BTLtech1/ripeomatic/data/contrib/README.md

# Contributed readings go in a folder named after the device id, e.g. contrib/a3f9c2/2026-11-09.csv
