BTLtech1/ripeomatic/hardware/stl/esp32-case/BTL-ESP32-case-Elegoo-DevKit-v6.3mf

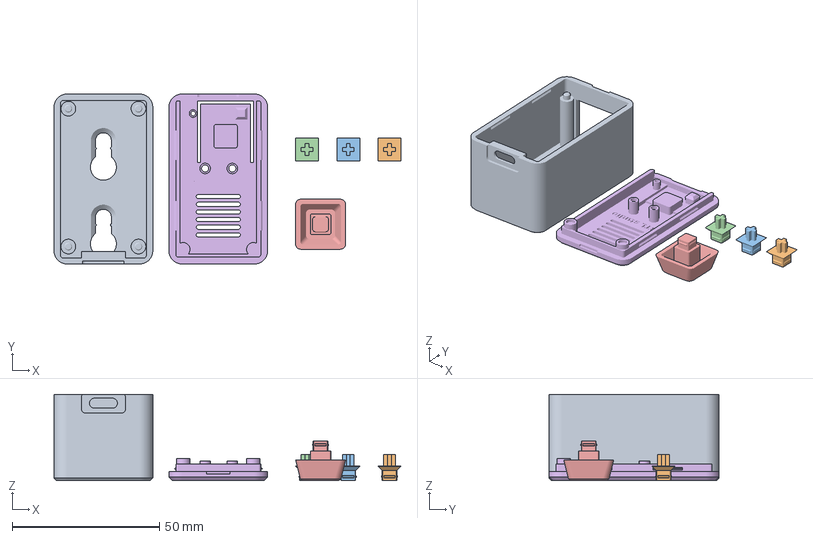
[picture p1: CAD file, 2026-11-07]
hardware/stl/esp32-case/BTL-ESP32-case-Elegoo-DevKit-v6.3mf
117.8 x 57.7 x 29.2 mm
base
MX adapter 1.35
MX adapter 1.30
MX adapter 1.25
keycap
lid (firm key)
