BTLtech1/ripeomatic/hardware/stl/gate-frame.stl

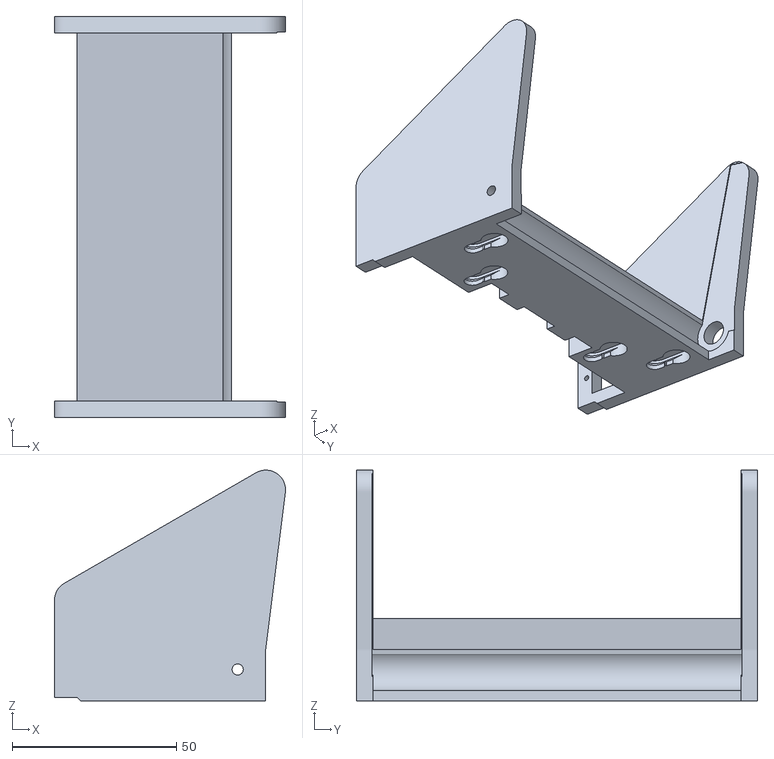
[picture p2: CAD file, 2026-11-14]
hardware/stl/gate-frame.stl
70.3 x 122.0 x 70.2
