BTLtech1/ripeomatic/hardware/stl/v45/v45-sled.stl

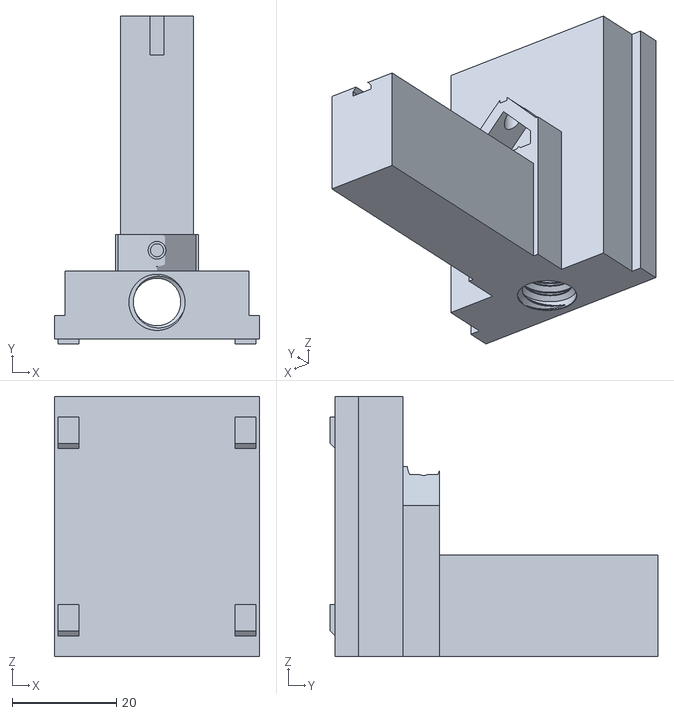
[picture p3: CAD file, 2026-11-12]
hardware/stl/v45/v45-sled.stl
39.4 x 63.0 x 50.0
