BTLtech1/ripeomatic/hardware/stl/esp32-case/esp32-case-mx-adapter-1.35.stl

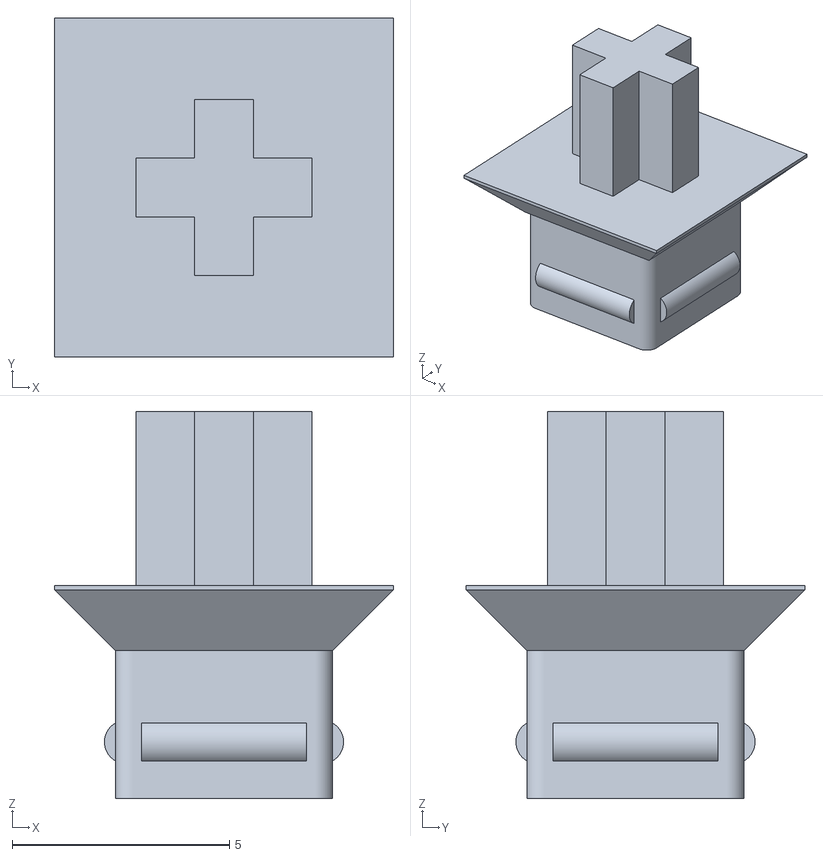
[picture p4: CAD file, 2026-11-07]
hardware/stl/esp32-case/esp32-case-mx-adapter-1.35.stl
7.80 x 7.80 x 8.90
