BTLtech1/ripeomatic/hardware/stl/ripeomatic-all-parts.3mf

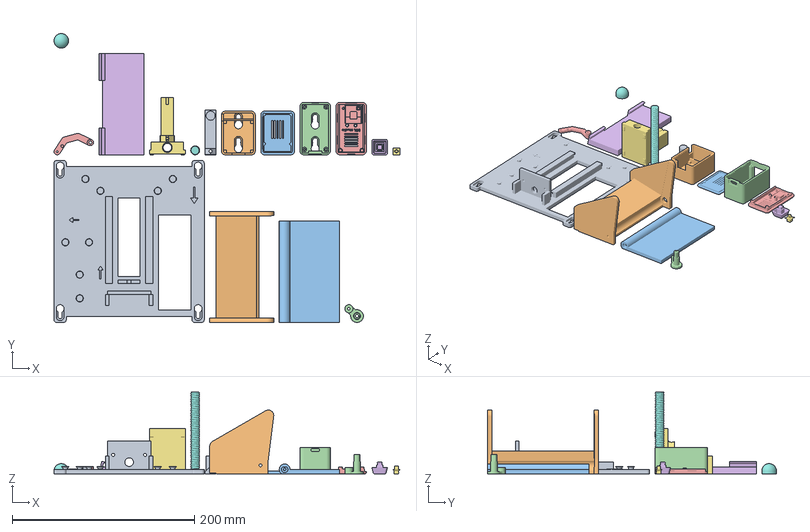
[picture p5: CAD file, 2026-11-14]
hardware/stl/ripeomatic-all-parts.3mf
379.9 x 317.2 x 90.0 mm
base
gate-frame
gate-door
gate-lever
gate-link
gate-liner-small
v45-sled
v45-lead-screw
v45-blade
driver-box
driver-box-lid
esp32-case-base
esp32-case-lid-firm-key
esp32-case-keycap
esp32-case-mx-adapter-1.30
pad-TPU
