BTLtech1/ripeomatic/hardware/stl/v45/v45-blade.stl

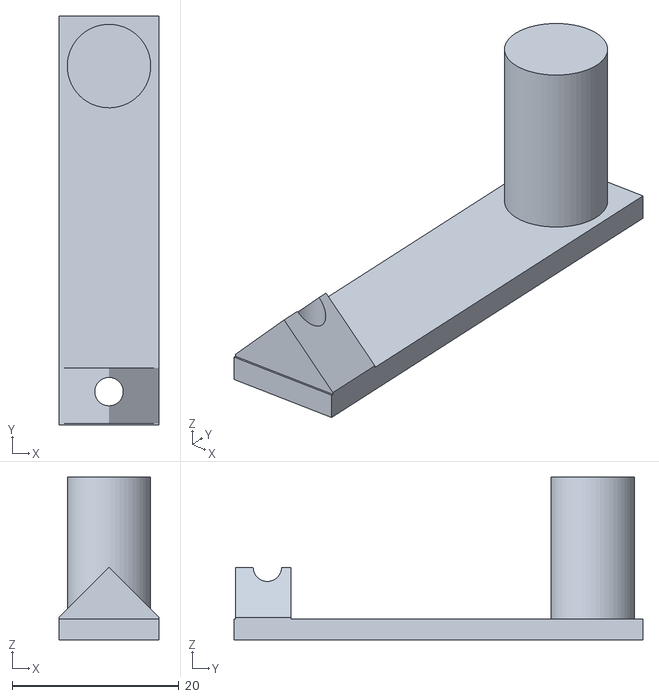
[picture p6: CAD file, 2026-11-09]
hardware/stl/v45/v45-blade.stl
12.0 x 49.0 x 19.5
