BTLtech1/ripeomatic/hardware/stl/base.stl

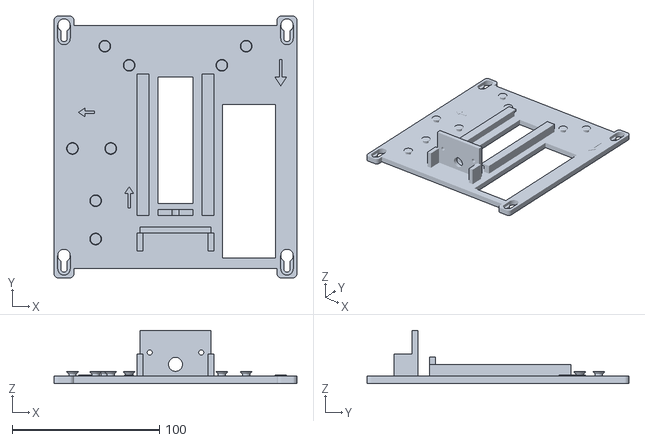
[picture p7: CAD file, 2026-11-14]
hardware/stl/base.stl
165.0 x 178.0 x 36.0
