BTLtech1/ripeomatic/hardware/stl/esp32-case/esp32-case-keycap.stl

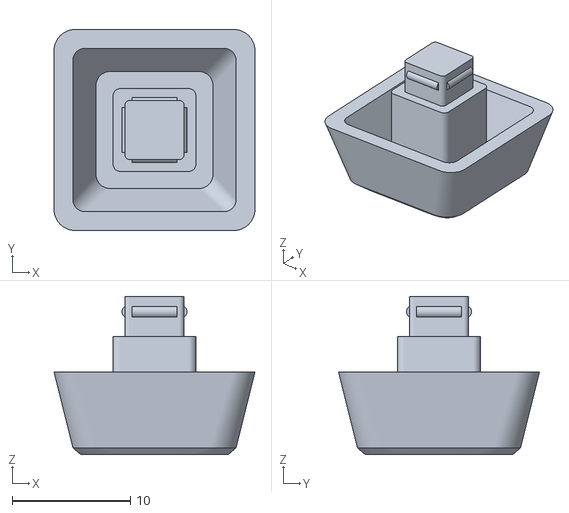
[picture p8: CAD file, 2026-11-07]
hardware/stl/esp32-case/esp32-case-keycap.stl
17.0 x 17.0 x 13.4
