BTLtech1/ripeomatic/hardware/stl/gate-liner-small.stl

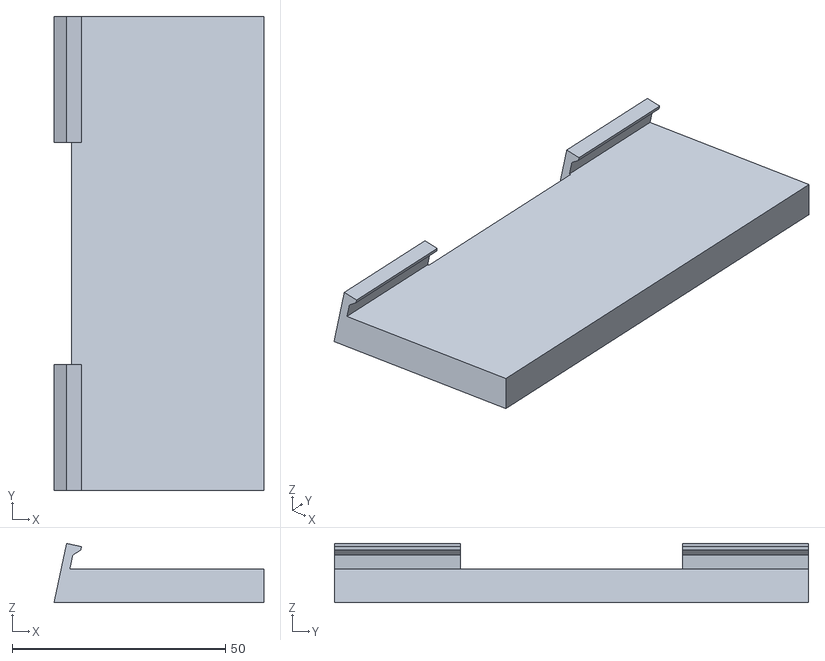
[picture p9: CAD file, 2026-11-12]
hardware/stl/gate-liner-small.stl
49.3 x 111.2 x 13.9
