BTLtech1/ripeomatic/hardware/stl/v45/v45-test-nuts.stl

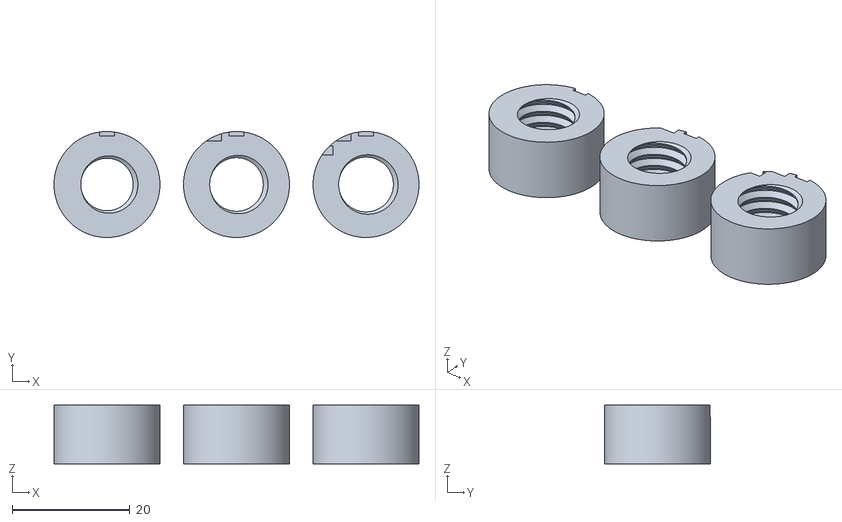
[picture p10: CAD file, 2026-11-08]
hardware/stl/v45/v45-test-nuts.stl
62.0 x 18.0 x 10.0
