BTLtech1/ripeomatic/hardware/stl/gate-door.stl

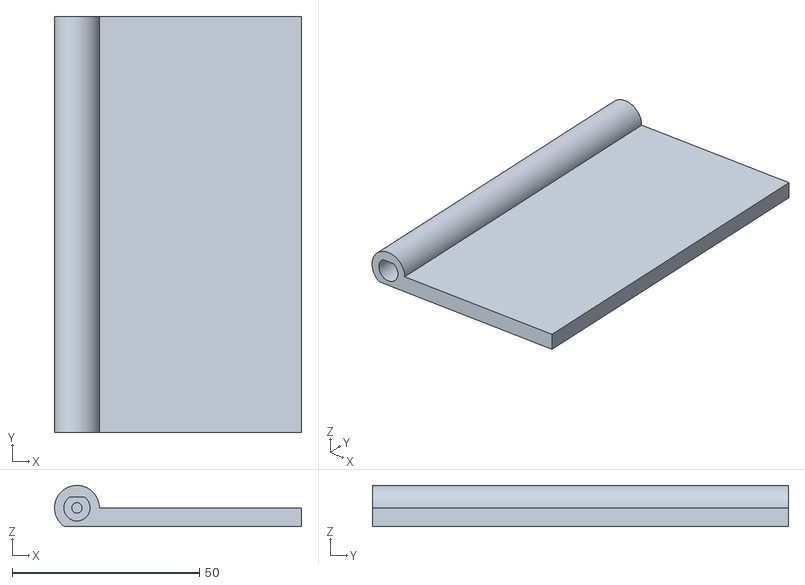
[picture p11: CAD file, 2026-11-12]
hardware/stl/gate-door.stl
66.0 x 111.2 x 11.0
