BTLtech1/ripeomatic/hardware/stl/esp32-case/esp32-case-lid-firm-key.stl

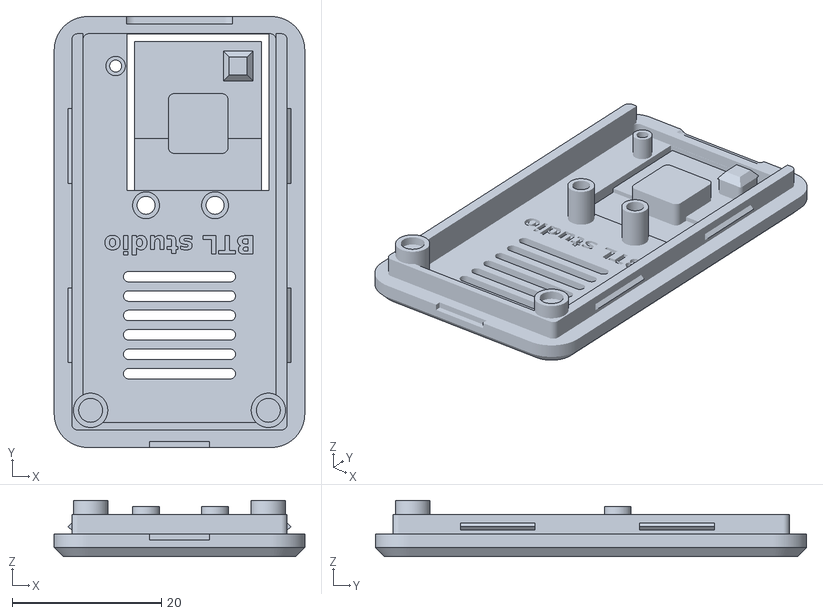
[picture p12: CAD file, 2026-11-07]
hardware/stl/esp32-case/esp32-case-lid-firm-key.stl
33.5 x 57.7 x 7.50
