BTLtech1/ripeomatic/hardware/stl/gate-link.stl

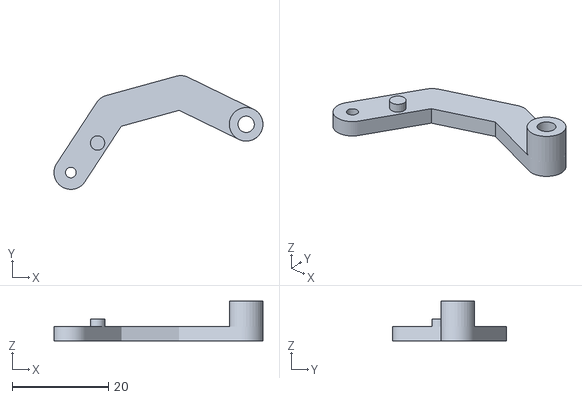
[picture p13: CAD file, 2026-11-12]
hardware/stl/gate-link.stl
43.5 x 23.7 x 8.30
