BTLtech1/ripeomatic/hardware/stl/esp32-case/esp32-case-base.stl

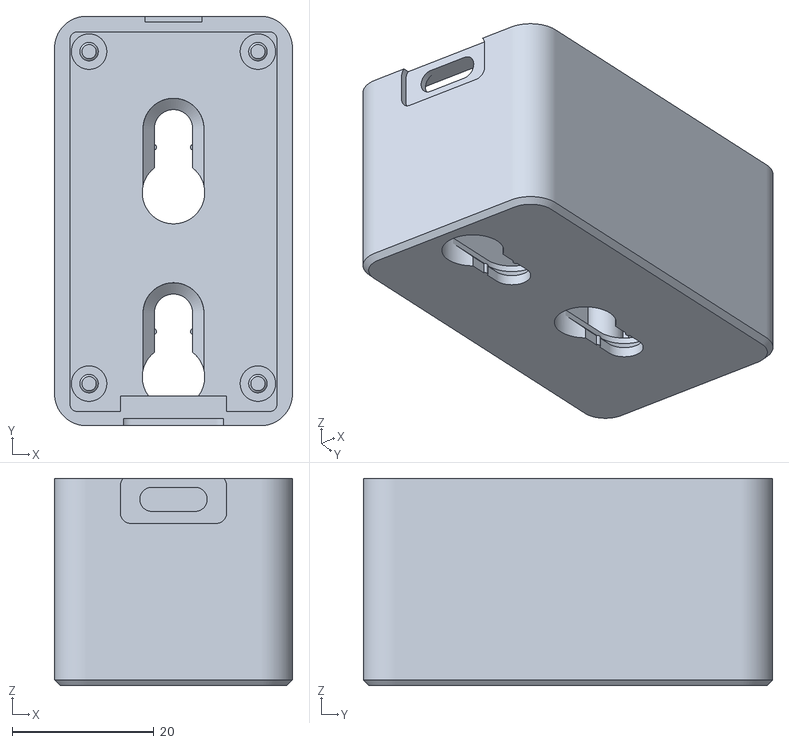
[picture p14: CAD file, 2026-11-07]
hardware/stl/esp32-case/esp32-case-base.stl
33.5 x 57.7 x 29.2
