BTLtech1/ripeomatic/hardware/stl/gate-lever.stl

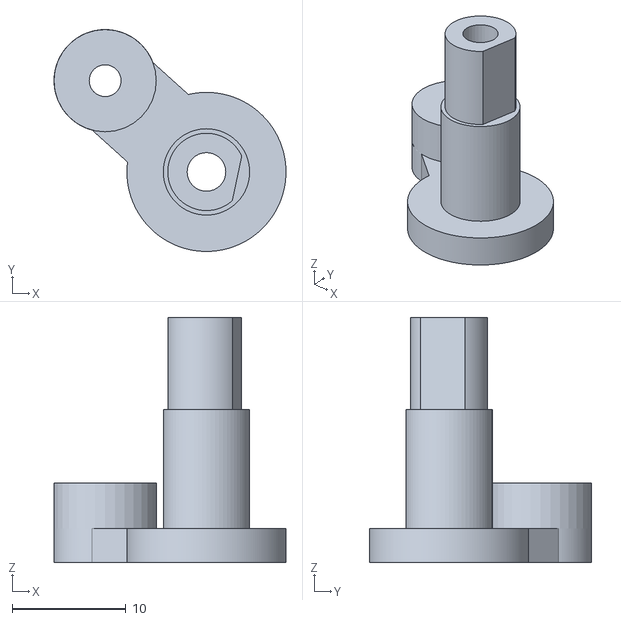
[picture p15: CAD file, 2026-11-12]
hardware/stl/gate-lever.stl
20.4 x 19.5 x 21.6
