BTLtech1/ripeomatic/hardware/stl/v-holder.stl

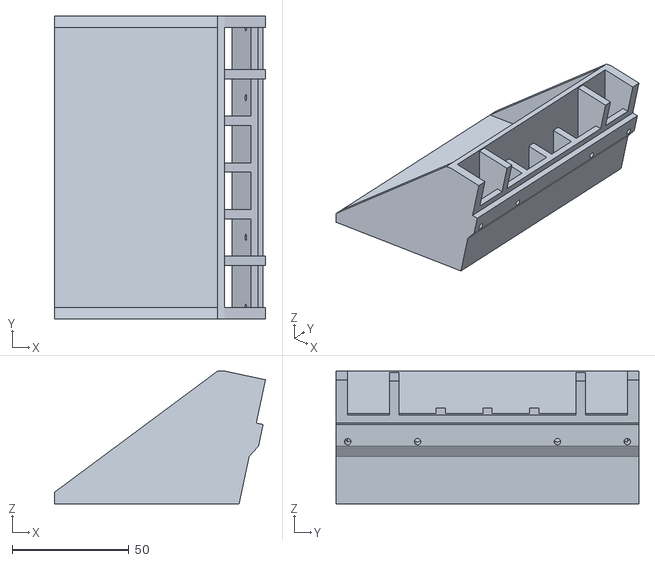
[picture p16: CAD file, 2026-11-12]
hardware/stl/v-holder.stl
90.5 x 130.0 x 57.0
