BTLtech1/ripeomatic/hardware/stl/base-v1-yoke-slot.stl

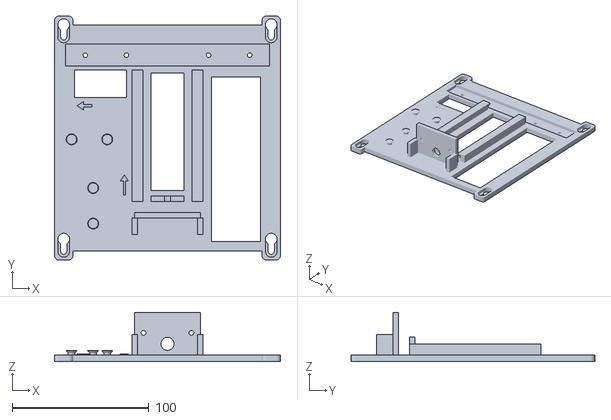
[picture p17: CAD file, 2026-11-12]
hardware/stl/base-v1-yoke-slot.stl
165.0 x 178.0 x 36.0
