BTLtech1/ripeomatic/hardware/stl/u-yoke.stl

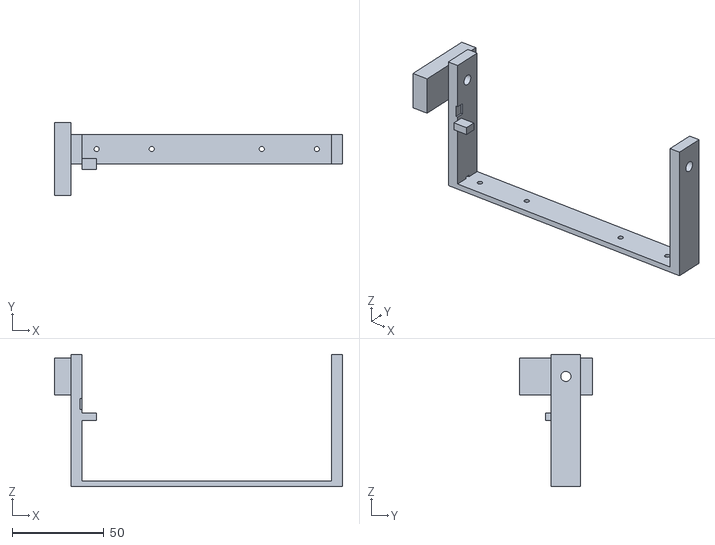
[picture p18: CAD file, 2026-11-12]
hardware/stl/u-yoke.stl
157.0 x 40.0 x 72.0
