BTLtech1/ripeomatic/hardware/stl/driver-box-lid.stl

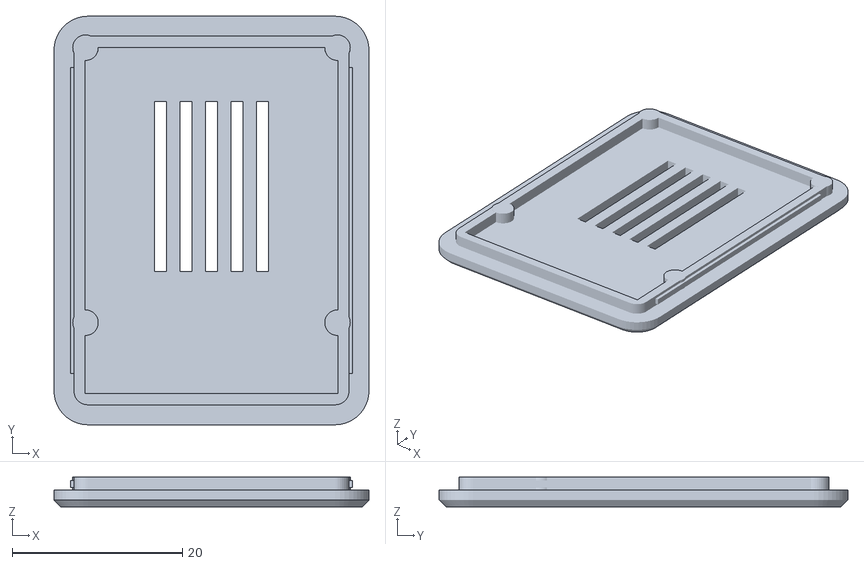
[picture p19: CAD file, 2026-11-09]
hardware/stl/driver-box-lid.stl
37.0 x 48.0 x 3.51
