BTLtech1/ripeomatic/hardware/stl/driver-box.stl

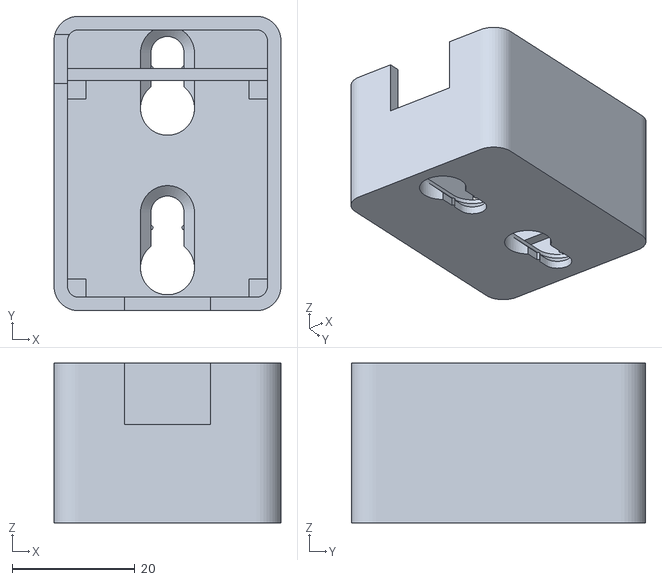
[picture p20: CAD file, 2026-11-07]
hardware/stl/driver-box.stl
37.0 x 48.0 x 26.0
