BTLtech1/ripeomatic/hardware/stl/nest.stl

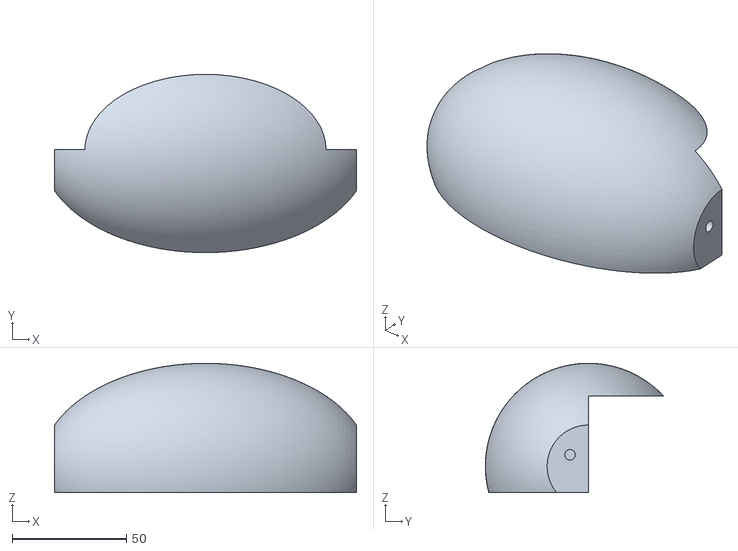
[picture p21: CAD file, 2026-11-06]
hardware/stl/nest.stl
132.0 x 77.9 x 56.6
