BTLtech1/ripeomatic/hardware/stl/servo-horn-v2.stl

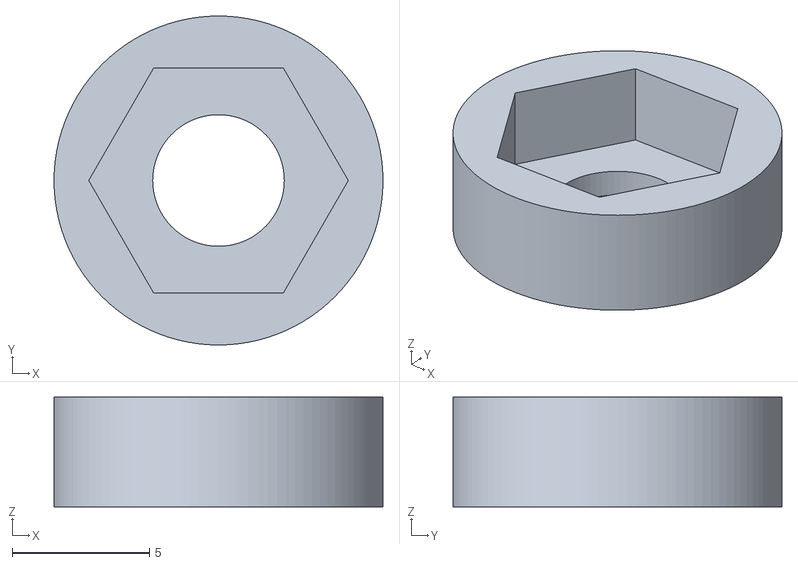
[picture p22: CAD file, 2026-11-06]
hardware/stl/servo-horn-v2.stl
12.0 x 12.0 x 4.00
