BTLtech1/ripeomatic/hardware/stl/blade.stl

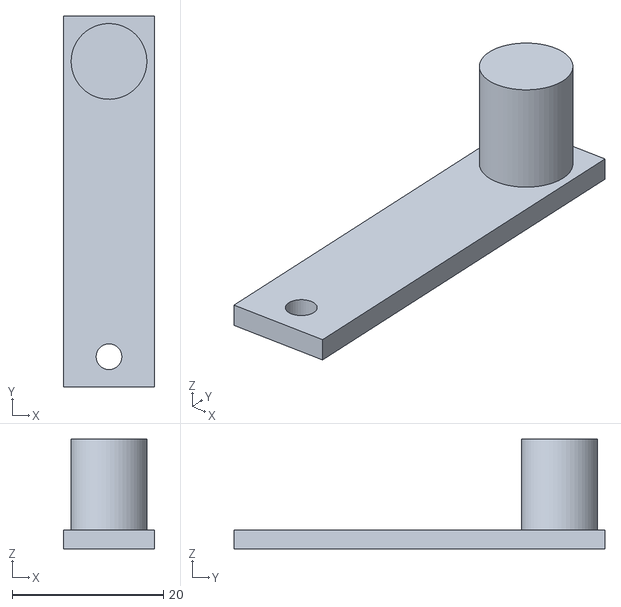
[picture p23: CAD file, 2026-11-06]
hardware/stl/blade.stl
12.0 x 49.0 x 14.5
