BTLtech1/ripeomatic/hardware/stl/pad-TPU.stl

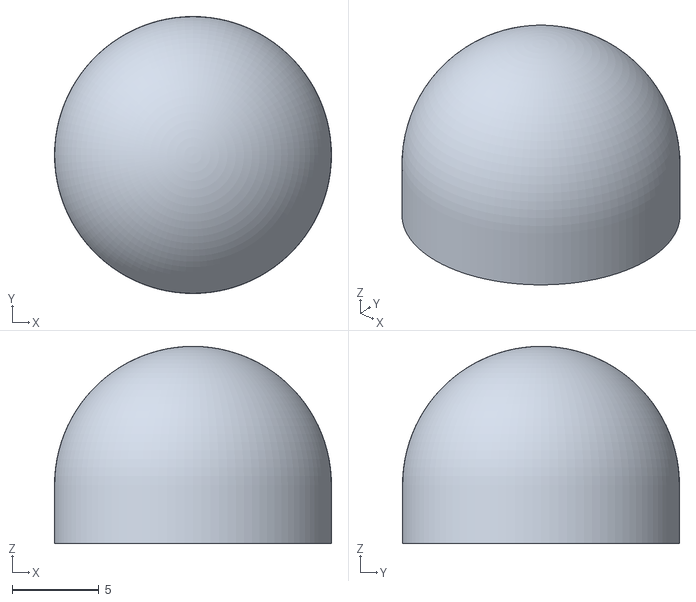
[picture p24: CAD file, 2026-11-06]
hardware/stl/pad-TPU.stl
16.0 x 16.0 x 11.4
