BTLtech1/ripeomatic/hardware/stl/nest-liner-TPU.stl

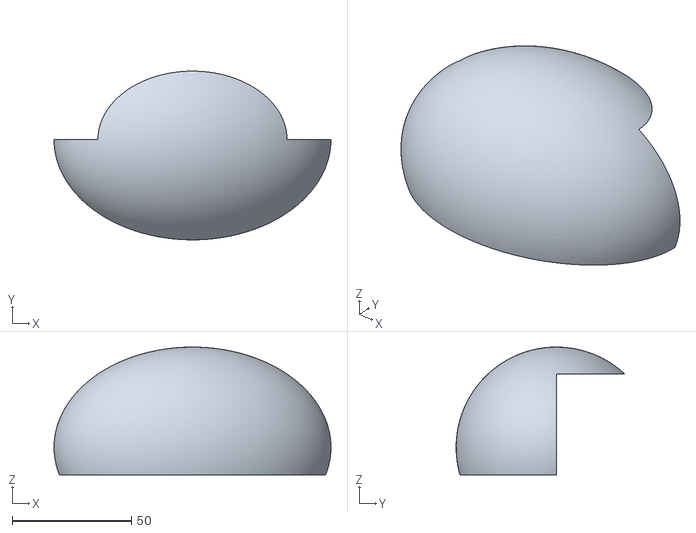
[picture p25: CAD file, 2026-11-06]
hardware/stl/nest-liner-TPU.stl
116.0 x 70.7 x 53.6
