BTLtech1/ripeomatic/(list of files, cad)

Other CAD files:
hardware/stl/esp32-case/esp32-case-mx-adapter-1.30.stl
hardware/stl/esp32-case/esp32-case-mx-adapter-1.25.stl
hardware/stl/sled.stl
hardware/stl/lead-screw-TR10x2.stl
hardware/stl/thumbscrew-knob.stl
hardware/stl/v45/v45-lead-screw.stl
hardware/stl/v45/v45-test-screw-30mm.stl
