BTLtech1/ripeomatic/firmware/ripeomatic/machine.h

// BTL Ripe-O-Matic: the machine. Owns the motor, the sensor, the measurement
// core and the fruit bookkeeping, and runs jobs (measure, jog, home, blade
// calibration, tip, notify) in their own FreeRTOS task so the web server keeps
// answering while the sled creeps for two minutes.
#pragma once
#include <Arduino.h>
#include "config.h"
#include "settings.h"
#include "measure.h"
#include "stepper.h"
#include "hall.h"
#include "storage.h"
#include "net.h"
#include "servo.h"
#include "updater.h"

enum class Job : uint8_t { Idle, Measure, Jog, Home, BladeCal, Tip, Notify, UpdateCheck, Update };

inline const char* jobName(Job j) {
  switch (j) {
    case Job::Idle: return "idle";
    case Job::Measure: return "measure";
    case Job::Jog: return "jog";
    case Job::Home: return "home";
    case Job::BladeCal: return "bladecal";
    case Job::Tip: return "tip";
    case Job::Notify: return "notify";
    case Job::UpdateCheck: return "updcheck";
    case Job::Update: return "update";
  }
  return "?";
}

struct LastReading {
  ripe::Outcome outcome = ripe::Outcome::None;
  char time[24] = "";
  float k = 0, r2 = 0, squish = 0, contact = 0, force_max = 0;
  int n_points = 0;
};

class Machine {
 public:
  Stepper28BYJ stepper;
  Hall hall;
  Storage store;
  Net net;
  NestServo servo;
  Updater upd;
  ripe::MeasureCore core;

  // live state for the UI (written by the job task, read by the web task)
  volatile Job job = Job::Idle;
  volatile ripe::Stage stage = ripe::Stage::Idle;
  volatile float live_force = 0;
  volatile float live_raw = 0;
  LastReading last;
  char error[64] = "";
  uint32_t last_measure_millis = 0;
  uint32_t boot_millis = 0;
  bool measured_since_boot = false;

  // A notification queued by the loop task (button) to be sent from the job task.
  char pendingTitle[32] = "", pendingMsg[96] = "";

  void begin() {
    boot_millis = millis();
    stepper.begin();
    applySettings();
    posLoad();
    hall.begin(&stepper);
    hall.tare();   // pad is normally in the air at boot; every reading tares again anyway
    store.begin();
    servo.begin();
    servo.relax();
  }

  void applySettings() {
    // Flipping the motor direction mirrors what "+" means, so mirror the step
    // count too: the sled hasn't moved, only the meaning of the sign.
    if (configured_ && S.motor_invert != lastInvert_) { stepper.setSteps(-stepper.steps()); posSave(false); }
    configured_ = true; lastInvert_ = S.motor_invert;
    stepper.configure(S.steps_per_mm, S.motor_invert);
    stepper.setSpeedMmS(S.fast_mm_s);
  }

  bool busy() const { return job != Job::Idle; }

  // ---- home ------------------------------------------------------------------
  // homeKnown: the step count matches the sled. homeLost: it was known, but the
  // power went off while the sled was moving, so the count can't be trusted.
  bool homeKnown = false;
  bool homeLost = false;

  // "Set home here": the sled is against the end stop at the motor end.
  bool setHomeHere() {
    if (busy()) return false;
    stepper.setSteps(0);
    homeKnown = true;
    homeLost = false;
    posSave(false);
    return true;
  }

  // Saved after every job that moves the sled; "moving" is set before it starts.
  void posSave(bool moving) {
    Preferences p; p.begin("pos", false);
    p.putInt("steps", (int)stepper.steps());
    p.putBool("known", homeKnown);
    p.putBool("moving", moving);
    p.end();
  }

  void posLoad() {
#if SIMULATE
    homeKnown = true;   // no motor: the count is always right
    return;
#endif
    Preferences p; p.begin("pos", false);
    bool known = p.getBool("known", false), moving = p.getBool("moving", false);
    long steps = p.getInt("steps", 0);
    p.end();
    if (known && !moving) { stepper.setSteps(steps); homeKnown = true; }
    else { homeKnown = false; homeLost = known && moving; }
  }

  // How far a jog may actually go (see jog()). 0 = nowhere.
  // past = the user confirmed the sled isn't really at home (the count is wrong, e.g. the motor lost
  // power for a while): a big step toward the motor may then go past home too.
  bool jogPast = false;
  float jogClamp(float mm, bool past = false) const {
    if (!homeKnown) return mm;
    float p = stepper.posMm();
    if (!past && mm < -1.01f && p + mm < 0) mm = p > 0 ? -p : 0;
    if (mm > 0 && p + mm > S.t.max_travel_mm) mm = p < S.t.max_travel_mm ? S.t.max_travel_mm - p : 0;
    return mm;
  }
  const char* jogBlocked(float mm, bool past = false) const {
    if (fabsf(jogClamp(mm, past)) >= 0.01f) return nullptr;
    return mm < 0 ? "at home. To creep closer to the end stop, use ◀ 1" : "at the travel limit";
  }

  static bool moves(Job j) { return j == Job::Measure || j == Job::BladeCal || j == Job::Jog || j == Job::Home; }

  // Both calibrations done: the force scale is known and the blade is subtracted.
  bool calibrated() const { return S.cal_points[0] != 0 && S.t.blade_k_n_per_mm > 0.01f; }

  // ---- starting jobs -------------------------------------------------------
  bool start(Job j, float param = 0) {
    if (busy()) return false;
    job = j;
    jobParam_ = param;
    stepper.clearAbort();
    error[0] = 0;
    if (moves(j)) posSave(true);   // if the power goes now, the count can't be trusted on the next boot
    // 16 kB: the ntfy push at the end runs TLS on this stack.
    BaseType_t ok = xTaskCreatePinnedToCore(taskEntry, "job", 16384, this, 1, &task_, 1);
    if (ok != pdPASS) { job = Job::Idle; strlcpy(error, "could not start task", sizeof error); return false; }
    return true;
  }

  void abort() { if (busy()) stepper.requestAbort(); }

  // A fresh, unguessable ntfy topic: ripe-<device id>-<6 random chars>.
  void newNtfyTopic() {
    static const char* alphabet = "abcdefghjkmnpqrstuvwxyz23456789";
    char rnd[7];
    for (int i = 0; i < 6; i++) rnd[i] = alphabet[esp_random() % 31];
    rnd[6] = 0;
    snprintf(S.ntfy_topic, sizeof S.ntfy_topic, "ripe-%s-%s", S.device_id, rnd);
    S.ntfy_ok = false;
    settingsSave();
  }

  // Queue a push notification; sent from the job task when it is free.
  void queueNotify(const char* title, const char* msg) {
    strlcpy(pendingTitle, title, sizeof pendingTitle);
    strlcpy(pendingMsg, msg, sizeof pendingMsg);
  }

  // Called from loop(): the scheduler.
  void tick() {
    if (busy()) return;
    if (pendingTitle[0]) { start(Job::Notify); return; }
    if (!S.auto_enabled) return;
    // Never press unattended until the machine has been set up: direction
    // checked, blade and force calibrated. Until then readings are manual.
    if (!calibrated() || !homeKnown) return;
    // ...and not while someone is in the middle of calibrating (machine on its back, coins on the pad).
    if (last_cal_millis_ && millis() - last_cal_millis_ < 10UL * 60 * 1000) return;
    uint32_t now = millis();
    // first reading a minute after boot, then every interval
    uint32_t due = measured_since_boot ? last_measure_millis + (uint32_t)(intervalHours() * 3600000.0f) : boot_millis + 60000;
    if ((int32_t)(now - due) >= 0) start(Job::Measure);
  }

  // Readings come faster once the fruit is nearly ripe.
  float intervalHours() const {
    float h = S.interval_h;
    if (FR.loaded && FR.last_k > 0) {
      ripe::Verdict v = ripe::judge(FR.last_k, FR.first_k, S.t);
      if (v == ripe::Verdict::Nearly) h = h / 2;
    }
    return h < 0.25f ? 0.25f : h;
  }

  int32_t secondsToNextAuto() const {
    if (!S.auto_enabled || !calibrated() || !homeKnown) return -1;
    uint32_t due = measured_since_boot ? last_measure_millis + (uint32_t)(intervalHours() * 3600000.0f) : boot_millis + 60000;
    int32_t d = (int32_t)(due - millis()) / 1000;
    return d < 0 ? 0 : d;
  }

  float thresholdNow() const {
    float thr = S.t.ripe_abs_n_per_mm > 0 ? S.t.ripe_abs_n_per_mm : 0;
    if (S.t.ripe_pct_of_first > 0 && FR.first_k > 0) {
      float rel = FR.first_k * S.t.ripe_pct_of_first / 100.0f;
      if (rel > thr) thr = rel;
    }
    return thr;
  }

  float elapsedDays() const {
    if (!FR.loaded) return -1;
    uint32_t now = Net::epoch();
    if (FR.start_epoch && now) return (now - FR.start_epoch) / 86400.0f;
    return (millis() - FR.start_millis) / 86400000.0f;
  }

  // Human rating from the web page or the button. Logged as its own row.
  bool rate(const char* rating, const char* cut, const char* notes) {
    char ts[24], fid[16], row[400];
    Net::isoNow(ts, sizeof ts);
    fruitId(fid, sizeof fid);
    ripe::RowMeta m{S.device_id, ts, fid, S.variety, 0, NAN, "", rating, cut ? cut : "", notes ? notes : ""};
    ripe::formatEventRow(m, row, sizeof row);
    strlcpy(FR.last_rating, rating, sizeof FR.last_rating);
    fruitSave();
    return store.appendRow(row);
  }

  // "New avocado" from the page: forget the current one; the next reading allocates the id.
  void forgetFruit() {
    FR.loaded = false;
    FR.last_contact_mm = 0;
    FR.last_rating[0] = 0;
    fruitSave();
  }

  // ---- force calibration ---------------------------------------------------
  float captureZero() {
    float raw = hall.readRaw(HALL_SAMPLES_TARE);
    S.cal_zero_counts = raw;
    S.cal_points[0] = 0;
    zeroCaptured_ = true;
    last_cal_millis_ = millis();
    settingsSave();
    return raw;
  }

  // Add a (grams, counts) point and refit newtons-per-count through the zero.
  // Requires a zero captured since boot, so a stale zero can't skew the scale.
  bool captureMass(float grams, const char** why) {
    *why = "";
    if (grams <= 0) { *why = "mass must be > 0"; return false; }
    if (!zeroCaptured_) { *why = "capture the zero first (nothing on the pad)"; return false; }
    float raw = hall.readRaw(HALL_SAMPLES_TARE);
#if SIMULATE
    raw = S.cal_zero_counts + grams / 1000.0f * 9.80665f / 0.0035f;   // pretend the coins are on the pad
#endif
    if (fabsf(raw - S.cal_zero_counts) < 3) { *why = "sensor didn't change: is the mass on the pad? is the magnet near the sensor?"; return false; }
    char pt[24];
    snprintf(pt, sizeof pt, "%s%.1f:%.0f", S.cal_points[0] ? ";" : "", grams, raw);
    if (strlen(S.cal_points) + strlen(pt) >= sizeof S.cal_points) { *why = "too many points; clear and redo"; return false; }
    strcat(S.cal_points, pt);
    refitCalibration();
    last_cal_millis_ = millis();
    settingsSave();
    return true;
  }

  int calPointCount() const {
    if (!S.cal_points[0]) return 0;
    int n = 1;
    for (const char* p = S.cal_points; *p; p++) if (*p == ';') n++;
    return n;
  }

  void clearCalibration() { S.cal_points[0] = 0; settingsSave(); }

  // ---- the jobs (run inside the task) -------------------------------------
 private:
  static void taskEntry(void* arg) {
    Machine* m = (Machine*)arg;
    m->runJob();
    if (moves(m->job)) m->posSave(false);
    m->job = Job::Idle;
    m->stage = ripe::Stage::Idle;
    m->task_ = nullptr;
    vTaskDelete(nullptr);
  }

  void runJob() {
    switch (job) {
      case Job::Measure:
        runMeasurement(false);
        // ripe and "drop ripe avocados" on: the sled has backed off, open the gate
        if (tipAfter_) { tipAfter_ = false; servo.tip(S.servo_rest_deg, S.servo_tip_deg, S.servo_hold_ms); }
        break;
      case Job::BladeCal: runMeasurement(true); break;
      case Job::Jog:      jog(jobParam_); stepper.release(); break;
      case Job::Home:     home(); stepper.release(); break;
      case Job::Tip:      servo.tip(S.servo_rest_deg, S.servo_tip_deg, S.servo_hold_ms); break;
      case Job::Notify:   net.notify(pendingTitle, pendingMsg, 2, "white_check_mark"); pendingTitle[0] = 0; pendingMsg[0] = 0; break;
      case Job::UpdateCheck: upd.check(); break;
      case Job::Update:
        stepper.release();
        if (upd.run()) { delay(2500); ESP.restart(); }   // let the page see "done" first
        break;
      default: break;
    }
  }

  // A move with no sensor-based stop condition of its own (homing, retract,
  // jog) still watches the sensor: if the raw reading changes by more than
  // `limit_n` worth of force from where it started, something is being pushed
  // that shouldn't be (inverted motor, wrong sign, fruit in the way) and the
  // move aborts. Sign- and tare-independent, so it works before calibration.
  bool guardedMove(float mm, float limit_n) {
    float npc = fabsf(S.hall_n_per_count) > 1e-6f ? fabsf(S.hall_n_per_count) : 0.0035f;
    float raw0 = hall.readRaw(16);
    float dir = mm >= 0 ? 1.0f : -1.0f, left = fabsf(mm);
    while (left > 0.001f && !stepper.aborted()) {
      float chunk = left > 0.5f ? 0.5f : left;
      stepper.moveMm(dir * chunk);
      left -= chunk;
      float raw = hall.readRaw(16);
      live_raw = raw;
      if (fabsf(raw - raw0) * npc > limit_n) {
        strlcpy(error, "unexpected force during a plain move: check motor_invert / the sensor sign", sizeof error);
        stepper.requestAbort();
        return false;
      }
    }
    return !stepper.aborted();
  }

  // Home is a step count, not a switch. The user sets it once with the sled
  // against the end stop ("Set home here"), the count is saved after every move,
  // and nothing ever drives into the stop on purpose: running into it made the
  // 28BYJ-48 pull the lead screw off its shaft instead of slipping.
  void home() {
    stage = ripe::Stage::Homing;
    if (!homeKnown) { strlcpy(error, HOME_UNSET_MSG, sizeof error); stepper.requestAbort(); return; }
    stepper.setSpeedMmS(S.fast_mm_s);
    float p = stepper.posMm();
    if (fabsf(p) > 0.001f) guardedMove(-p, 1.5f);
  }

  // Jog from the Motor panel. With home set, big steps stop at home and at the
  // travel limit; a 1 mm step toward the motor may go past home, so a wrong home
  // can be corrected by creeping up to the real end stop.
  void jog(float mm) {
    mm = jogClamp(mm, jogPast);
    jogPast = false;
    if (fabsf(mm) < 0.01f) return;
    guardedMove(mm, S.t.force_cap_n);
  }

  void runMeasurement(bool bladeCal) {
    ripe::Tunables t = S.t;
    if (bladeCal) t.blade_k_n_per_mm = 0;   // we want the raw machine slope
    // Until the force scale is calibrated the cap is a guess: keep the
    // position backstop short so a wrong guess can't turn into a deep press.
    if (!S.cal_points[0] && t.max_squish_mm > 3.0f) t.max_squish_mm = 3.0f;

    if (!homeKnown) { finishAborted(HOME_UNSET_MSG); return; }
    home();
    if (stepper.aborted()) { finishAborted(error[0] ? error : "stopped"); return; }

    stage = ripe::Stage::Taring;
    delay(300);                     // let the blade stop wobbling
    hall.tare();
    live_raw = hall.tareCounts();
    live_force = 0;
    if (live_raw < 20 || live_raw > 4075) { finishAborted("hall sensor saturated: magnet too close/far, or wiring"); retract(); return; }

    core.start(t, bladeCal ? 0 : FR.last_contact_mm);
    stage = core.stage();
    float pos = stepper.posMm();
    float force = hall.readForce();
    int negativeRun = 0;
    while (true) {
      ripe::MeasureCore::Cmd c = core.feed(pos, force);
      stage = core.stage();
      if (c.kind == ripe::MeasureCore::Cmd::Stop) break;
      stepper.setSpeedMmS(c.fast ? S.fast_mm_s : S.creep_mm_s);
      stepper.moveMm(c.mm);
      if (stepper.aborted()) { core.abort(); break; }
      pos = stepper.posMm();
      float raw = hall.readRaw(HALL_SAMPLES_LIVE);
      force = hall.countsToForce(raw);
      live_raw = raw;
      live_force = force;
      // Sensor sanity. The force should never go strongly negative while we
      // push: if it does, hall_n_per_count has the wrong sign (or the magnet
      // is flipped). One sample well below zero is enough during the fast
      // approach, where each step is 0.5 mm.
      bool bad = force < -0.5f * t.force_cap_n;
      if (force < -3 * t.contact_threshold_n) bad = bad || ++negativeRun >= 2; else negativeRun = 0;
      if (bad) { core.abort(); strlcpy(error, "force reads negative: flip the sign of hall_n_per_count (or the magnet)", sizeof error); break; }
      if (raw < 20 || raw > 4075) { core.abort(); strlcpy(error, "hall sensor saturated: magnet too close/far, or wiring", sizeof error); break; }
    }

    retract();

    const ripe::Reading& r = core.reading();
    char ts[24];
    Net::isoNow(ts, sizeof ts);
    last.outcome = r.outcome;
    if (ts[0]) strlcpy(last.time, ts, sizeof last.time);
    else snprintf(last.time, sizeof last.time, "up+%lu", (unsigned long)(millis() / 1000));   // clock not set yet
    last.k = r.stiffness_n_per_mm; last.r2 = r.r2; last.squish = r.squish_at_cap_mm;
    last.contact = r.contact_pos_mm; last.force_max = r.force_max_n; last.n_points = r.n_points;
    last_measure_millis = millis();
    measured_since_boot = true;

    if (bladeCal) {
      if (r.outcome == ripe::Outcome::Reading && r.stiffness_n_per_mm > 0.2f) {
        S.t.blade_k_n_per_mm = r.stiffness_n_per_mm;
        last_cal_millis_ = millis();
        settingsSave();
        Serial.printf("blade_k = %.2f N/mm (r2 %.3f)\n", r.stiffness_n_per_mm, r.r2);
      } else if (!error[0]) {
        strlcpy(error, "blade calibration failed: nothing hard where the avocado goes?", sizeof error);
      }
      return;
    }

    switch (r.outcome) {
      case ripe::Outcome::Reading:
      case ripe::Outcome::Overtravel:
        processReading(r, ts);
        break;
      case ripe::Outcome::Empty:
        if (FR.loaded) {
          FR.loaded = false;
          fruitSave();
          net.notify("No avocado", "The avocado is gone. Put the next one in.", 2, "avocado");
        }
        break;
      case ripe::Outcome::Aborted:
        if (!error[0]) strlcpy(error, "stopped", sizeof error);
        break;
      default: break;
    }
  }

  // Always come back and let go of the fruit, even after an abort.
  void retract() {
    stage = ripe::Stage::Retract;
    stepper.clearAbort();
    stepper.setSpeedMmS(S.fast_mm_s);
    guardedMove(-stepper.posMm(), S.t.force_cap_n + 1.0f);   // back to home by count; never into the stop
    stepper.release();
    stepper.clearAbort();
  }

  void finishAborted(const char* why) {
    strlcpy(error, why, sizeof error);
    last.outcome = ripe::Outcome::Aborted;
    stepper.clearAbort();
    stepper.release();
  }

  void processReading(const ripe::Reading& r, const char* ts) {
    // New avocado?
    bool isNew = !FR.loaded || ripe::looksLikeNewFruit(r.contact_pos_mm, FR.first_contact_mm, r.stiffness_n_per_mm, FR.last_k, S.t);
    if (isNew) {
      fruitNew();
      FR.loaded = true;
      FR.first_contact_mm = r.contact_pos_mm;
      FR.first_k = r.stiffness_n_per_mm;
      FR.start_epoch = Net::epoch();
      FR.start_millis = millis();
    }
    FR.last_k = r.stiffness_n_per_mm;
    FR.last_contact_mm = r.contact_pos_mm;
    FR.n_readings++;
    FR.last_rating[0] = 0;

    // Log it.
    char fid[16], row[700], notes[48] = "";
    fruitId(fid, sizeof fid);
    if (r.outcome == ripe::Outcome::Overtravel) strlcpy(notes, "overtravel: cap not reached", sizeof notes);
    else if (isNew && FR.counter > 1) strlcpy(notes, "new fruit detected", sizeof notes);
    ripe::RowMeta m{S.device_id, ts, fid, S.variety, 0, NAN, S.cal_points, "", "", notes};
    ripe::formatReadingRow(r, m, S.t.force_cap_n, row, sizeof row);
    store.appendRow(row);
    Serial.println(row);

    // Verdict + notifications (once per fruit each).
    ripe::Verdict v = ripe::judge(FR.last_k, FR.first_k, S.t);
    char msg[160];
    if (v == ripe::Verdict::Ripe && !FR.notified_ripe) {
      snprintf(msg, sizeof msg, "Stiffness %.2f N/mm (%.0f%% of day 1). Eat it today or fridge it.", FR.last_k, FR.first_k > 0 ? 100 * FR.last_k / FR.first_k : 0);
      bool drop = S.gate_auto && S.gate_fitted && ENABLE_SERVO;
      if (drop) { strlcat(msg, " It's in the basket.", sizeof msg); tipAfter_ = true; }
      if (net.notify("Avocado is ripe", msg, 4, "avocado,tada")) FR.notified_ripe = true;
    } else if (v == ripe::Verdict::Nearly && S.notify_nearly && !FR.notified_nearly) {
      float d = ripe::daysToRipe(FR.first_k, FR.last_k, elapsedDays(), thresholdNow());
      snprintf(msg, sizeof msg, "Stiffness %.2f N/mm. Probably ripe %s.", FR.last_k, d > 0 && d < 1.5f ? "tomorrow" : "in a day or two");
      if (net.notify("Avocado almost ripe", msg, 3, "avocado")) FR.notified_nearly = true;
    }
    fruitSave();
  }

  void refitCalibration() {
    // points: grams:counts;...  fit force (N) vs (counts - zero), least squares including (0,0)
    float x[6], y[6];
    int n = 0;
    x[n] = 0; y[n] = 0; n++;
    const char* p = S.cal_points;
    while (*p && n < 6) {
      float g = atof(p);
      const char* c = strchr(p, ':');
      if (!c) break;
      float counts = atof(c + 1);
      x[n] = counts - S.cal_zero_counts;
      y[n] = g / 1000.0f * 9.80665f;
      n++;
      const char* s = strchr(p, ';');
      if (!s) break;
      p = s + 1;
    }
    if (n >= 2) {
      ripe::LineFit f = ripe::fitLine(x, y, n);
      if (fabsf(f.slope) > 1e-7f) {
        float old_npc = S.hall_n_per_count;
        S.hall_n_per_count = f.slope;
        // blade_k was measured in newtons of the OLD scale; it scales exactly with the sensor scale.
        if (S.t.blade_k_n_per_mm > 0 && fabsf(old_npc) > 1e-7f) S.t.blade_k_n_per_mm *= fabsf(f.slope / old_npc);
      }
    }
  }

  TaskHandle_t task_ = nullptr;
  float jobParam_ = 0;
  bool configured_ = false, lastInvert_ = false;
  bool tipAfter_ = false;       // set by processReading when a ripe fruit should go in the basket
  bool zeroCaptured_ = false;   // captureZero() done since boot
  uint32_t last_cal_millis_ = 0;
};

extern Machine M;
