BTLtech1/ripeomatic/(commit log)

2026-11-03 Initial project structure
    README, measurement routine, hardware BOM, firmware plan,
    data template, MIT (code) and CC BY-SA 4.0 (hardware) licenses.
    Claude-Session: https://claude.ai/code/session_01Nn3xvgmK6v36sKnHTDxFfD
    [readings_template.csv]
2026-11-03 Switch to the printable edition: $15-20 BOM, no bearings or load cell
    28BYJ-48 geared stepper on a printed lead screw, carriage sliding on
    printed posts, printed PLA flexure + SS49E hall sensor for force
    sensing, everything on 5 V USB. Updated BOM, wiring, firmware
    settings and the measurement routine (flexure correction, coin
    calibration).
    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
2026-11-03 Move the motor to the base
    Motor sits shaft-up in a printed cup in the base plate, next to its
    driver. Lead screw gets a thrust flange under the top plate; top plate
    becomes a plain post cap. Only the hall sensor lead moves now.
    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
2026-11-03 Switch to the horizontal press layout
    Low caliper-style press: one flat base print with a guide channel,
    motor plate, end stop, V-trough and soft backstop. Sled slides in the
    channel; a vertical printed blade with magnet + hall sensor reads force.
    Push reaction seats the screw on the motor shaft, so no retaining
    flange. Docs, BOM, wiring and measurement routine updated.
    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
2026-11-03 Nest instead of trough and backstop; pad on a stem; hinge knuckle for v2
    Half-shell avocado nest with soft liner and front lip replaces the two
    rails and wall. Pad moves to a 12 mm stem so the sled clears the
    pedestal for small fruit; far screw bracket moved. GoPro-style hinge
    knuckle at the nest's rear edge, with v2 tipping servo noted.
    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
2026-11-03 Trunnion hinge through the fruit centre instead of a rear-edge knuckle
    Nest hangs between two yoke arms on M5 pins at pad height. The push
    passes through the axis so readings can't tip it, and the loaded nest
    is nearly balanced for the v2 tipping servo.
    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
2026-11-03 Compact layout: 40 mm travel, 90 mm screw, 185 x 150 base; nest sized for 80 mm fruit
    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
2026-11-03 Longer sled with runner pads, no far screw bracket; friction notes
    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
2026-11-03 U-yoke printed flat, rib ears on the nest, servo planned into v1 print
    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
2026-11-03 Scoop-cut nest for a 110 degree dump; servo boss and stop tab; base trimmed behind the yoke
    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
2026-11-03 Fusion 360 model and STLs for v1
    Base 165x165 with lightening windows, rails, motor plate, yoke recess,
    board mounts; sled with TR10x2 nut, post and blade riser; blade; pad;
    TR10x2 lead screw; scoop nest with hinge ears; TPU liner; U-yoke with
    stop tab and servo boss; knob; v2 servo horn. Print/assembly guide.
    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
    [base.stl, blade.stl, lead-screw-TR10x2.stl, nest-liner-TPU.stl, nest.stl, pad-TPU.stl, servo-horn-v2.stl, sled.stl]
2026-11-03 Rounded hinge lugs on the nest
    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
    [nest.stl]
2026-11-03 Flat-ended nest: bolts thread into 8 mm end walls, no lugs; yoke arms moved in to match
    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
    [nest-liner-TPU.stl, nest.stl, servo-horn-v2.stl, thumbscrew-knob.stl, u-yoke.stl]
2026-11-03 Data-sharing plan: record schema, collection path, pooled-data uses; capacitor in wiring notes
    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
2026-11-03 Slide-in cradle for the ULN2003 instead of standoffs; groove fix on both cradles
    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
    [base.stl]
2026-11-03 Board cover: drop-over lid for the ESP32 and ULN2003 cradles
    1.2 mm walls, vent slots, wire gap on the inner edge, USB notch and a
    hook tab at the nest end, one M3 boss at the other end screwed from
    below (new 3.4 mm hole in the base). Notched where it meets the ULN
    cradle rail ends. Docs: print list, hardware, assembly step, and a note
    that the ESP32 goes in USB toward the nest.
    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
    [base.stl, board-cover.stl]
2026-11-03 Firmware first pass: measurement state machine, web app, CSV log, ntfy push
    One ESP32 sketch, core libraries only. measure.h is pure C++ and unit-tested
    against a simulated avocado (recovers the fruit's stiffness through the blade
    correction, finds contact to 0.1 mm, handles empty nest / mush / close fruit).
    machine.h runs home-tare-approach-creep-press-retract in its own task, detects
    swaps, logs schema-v1 rows to LittleFS and pushes 'almost ripe' / 'ripe' /
    'nest empty' through ntfy. web.h serves the embedded page (PWA) and a JSON
    API; net.h does a setup AP with captive portal, mDNS, NTP. Coin + blade
    calibration wizard, motor jog, settings, Wi-Fi from the page; BOOT button
    measures / rate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
2026-11-03 Data pipeline: validator/merge script, GitHub Actions, synthetic sample
    tools/merge_data.py checks contrib/<device_id>/*.csv against schema v1 (header,
    ids, ISO timestamps, numeric columns, rating/cut vocabularies, curve format),
    dedups and writes data/all.csv. The data workflow validates PRs and rebuilds
    all.csv on main. The firmware workflow runs the unit tests, the sketch
    type-check, the ui.h freshness check and the headless-browser smoke test
    against the mock device. tools/make_sample.py writes a clearly synthetic
    data/sample/sample.csv (device 000000) for trying the dashboard.
    Claude-Session: https://claude.ai/code/session_01Nn3x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
    [readings_template.csv, sample.csv]
2026-11-03 data: rebuild all.csv
    [all.csv]
2026-11-03 Community dashboard on GitHub Pages
    dashboard/index.html reads data/all.csv (falls back to the synthetic sample
    with a banner, or opens a CSV from your computer): hero tile with the median
    stiffness at 'perfect', ripening curves with rating markers and nearest-point
    hover, stiffness-by-rating strip, days-to-perfect vs temperature, sortable
    table, variety/device filters, light and dark. pages.yml deploys it to
    https://btltech1.github.io/ripeomatic/ (enable Pages: Settings > Pages >
    Source: GitHub Actions, if the workflow can't turn it on itself).
    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
2026-11-03 Wiring diagram for the hardware README
    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
2026-11-03 Firmware: fixes from an independent review before first flash
    Blocker: Net::ntfy() let HTTPClient outlive the WiFiClient it was given
    (use-after-free in end(); would have reboot-looped on every notification).
    Safety: automatic readings stay off until both calibrations are done and for
    10 min after any calibration capture; homing, retract and jog are now guarded
    moves that abort if the sensor reading changes by more than the force cap
    (catches an inverted motor or wrong sensor sign before anything is pushed);
    hall saturation aborts a press; the squish backstop drops to 3 mm while the
    force scale is still a guess; wrong-sign detection trips on the first strongly
    negative sample during the fas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
    [config.h, machine.h, mock_device.py, net.h, ripeomatic.ino, settings.h, web.h]
2026-11-03 SIMULATE: fake the coin mass so the calibration flow works on a bare board
    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
2026-11-05 CI: compile the firmware with the real ESP32 toolchain, export single-image binaries
    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
2026-11-05 Improv Wi-Fi over serial; min_spiffs partition (app was at 95%); unpadded merged image
    improv.h answers the web installer's Improv Serial protocol: device info,
    state, network scan, and Wi-Fi settings (connects, saves, replies with the
    device URL, reboots into station mode). Framing/checksum is host-tested.
    The real-toolchain build showed the sketch at 95% of the default 1.25 MB app
    partition, so the build, PlatformIO and the README now use Minimal SPIFFS
    (1.9 MB app with OTA, 190 kB filesystem; log rotation at 80 kB). CI merges
    the image with esptool so it is ~1.3 MB rather than a padded 4 MB.
    Claude-Session: https://claude.ai/code/s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
    [config.h, improv.h, ripeomatic.ino]
2026-11-05 Device page: first-run setup checklist (alerts, motor direction, calibrations, first avocado)
    One step at a time, with the firmware doing the thinking: /api/ntfy/new makes a
    private topic and the page links the phone straight to it, /api/ntfy/test
    sends a push from the job task and ticks the step when it lands, and
    /api/motor/checked turns 'it went the wrong way' into a motor_invert flip.
    Calibration steps moved from the settings panel into the checklist. The mock
    and the browser smoke test walk all five steps.
    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
    [machine.h, mock_device.py, net.h, settings.h, web.h]
2026-11-05 Installer: 'which one is the board' help, Install button labels, 2.4 GHz tip (from the print bridge installer)
    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
2026-11-05 Docs: the hall sensor capacitor is optional
    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
2026-11-05 Installer: device names as non-wrapping chips
    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
2026-11-05 Installer: name the CP2102 entry exactly, explain the Paired tag, driver step inline
    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
2026-11-05 Installer: Windows driver as its own step for the ELEGOO/CP2102 board; tested-board notes
    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
2026-11-05 Device page: Wi-Fi panel says what it's for (connected to X; change only if the network changes)
    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
2026-11-05 Simulation: 20x motor speed so a pretend reading takes ~10 s; page says it's a simulation
    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
2026-11-06 STLs rotated into print orientation; tools/orient_stl.py; print guide corrected
    The Fusion exports were in model coordinates (Y up), so every part landed on
    its side in the slicer. orient_stl.py rotates each file per a per-part rule,
    rests it on Z=0 and centres it, and reports footprint and bed contact. That
    check showed the guide was wrong for two parts: the nest 'cup up' rests on a
    point (now upside down on its flat top edge, 1150 mm2 of contact, no
    supports) and the U-yoke can't lie flat because the servo boss is wider than
    the arm (now standing on its cross-bar with supports under the boss; a later
    CAD revision should widen the arm there).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
    [base.stl, blade.stl, board-cover.stl, lead-screw-TR10x2.stl, nest-liner-TPU.stl, nest.stl, pad-TPU.stl, servo-horn-v2.stl]
2026-11-07 Base: keyhole studs for a slide-on electronics box, cradles and cover retired
    The slide-in board cradles could not hold a DevKit (the pin headers sit at
    the board edge, so there is no edge for the grooves to grip). The shelf is
    now flat with two BTL universal-mount v3 studs 26 mm apart (stem Ø5 × 1.4,
    45° cone to Ø8, 3.3 mm tall), so any box with the matching keyholes slides
    on and clamps itself. Cradle features and the cover screw hole are
    suppressed in the Fusion timeline, not deleted; board-cover.stl is dropped.
    - hardware/keyhole-mount.md: stud and keyhole dimensions, shelf size,
    stud positions, how to get the cradle version back
    - print guide / hardware README / README: box inste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
    [base.stl, board-cover.stl]
2026-11-07 Two electronics boxes on keyhole studs: BTL ESP32 case v6 + new driver box
    The ESP32 goes in BTL's existing ESP32 case for the ELEGOO DevKit (v6, with
    the BOOT keycap), the ULN2003 in a new driver box drawn in the same style.
    Both click onto BTL universal-mount studs printed into the base, one pair
    each side of the channel at the motor end; part of the far-side window is
    filled in to carry the second pair. The keyhole spec now comes from the v6
    case itself (Ø8.8 round, 5.4 slot, 9 mm slide, 45° flare, detent nibs).
    - hardware/stl/base.stl: four studs, window fill
    - hardware/stl/driver-box.stl, driver-box-lid.stl: new (Fusion component
    DriverBox: keyhole floor, board ledges, wire notches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
    [BTL-ESP32-case-Elegoo-DevKit-v6.3mf, base.stl, driver-box-lid.stl, driver-box.stl, esp32-case-base.stl, esp32-case-keycap.stl, esp32-case-lid-firm-key.stl, esp32-case-mx-adapter-1.25.stl]
2026-11-07 Sled: prints standing on its motor end, short nut
    The screw got tighter and tighter through the 50 mm printed nut. Now only
    the motor-end 10 mm is threaded (Ø10.8 clearance beyond, 0.6 mm lead-in
    against elephant's foot), and the hall post and riser run down to the
    motor-end face so the sled prints standing on it: thread vertical like the
    screw's, no supports.
    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
    [sled.stl]
2026-11-07 Base: both boxes on the board side, corner mounting keyholes
    Driver box moved beside the ESP32 case, crosswise, so all wiring stays on
    one side; far-side studs and window fill removed. Four corner ears with
    screw keyholes (hang over screw heads or screw down); base is 178 x 165.
    Print guide: box order and corner keyholes.
    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
    [base.stl]
2026-11-07 Sled: sloped pad ends; plates_3mf --split writes one 3MF per plate
    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
    [sled.stl]
2026-11-08 tools/v45_thread.py: experimental 45-degree V thread (screw, sled nut, test pieces)
    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
2026-11-08 Base: keyholes flipped (slot against the surface), UNLOCK arrows for both boxes, label strip
    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
    [base.stl]
2026-11-08 Document the printable V45 thread: profile, tolerances, test results, files
    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
    [v45-lead-screw.stl, v45-sled.stl, v45-test-nuts.stl, v45-test-screw-30mm.stl]
2026-11-08 V45 sled: zig-zag blade slot roof (no bridge, no clamp screw)
    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
    [v45-sled.stl]
2026-11-08 V45: single 45-degree arch blade slot + ridged blade with 5 mm longer stem (max_travel 37)
    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
    [v45-blade.stl, v45-sled.stl]
2026-11-08 V45 sled/blade: crush ribs + tighter ridge so the blade holds without a screw; optional M3x20 hole
    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
    [v45-blade.stl, v45-sled.stl]
2026-11-09 V45 blade: magnet pocket 3.4 x 2.1 deep (magnet flush)
    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
    [v45-blade.stl]
2026-11-09 Driver-box lid: hold-down pegs removed; base: four leftover ULN2003 screw dimples filled
    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
    [base.stl, driver-box-lid.stl]
2026-11-12 Experimental dovetail yoke mount (no screws): tools/dovetail_yoke.py + test STLs
    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
    [dovetail-base.stl, dovetail-keeper.stl, dovetail-u-yoke.stl]
2026-11-12 Base/yoke: M3 holes sized to fit (3.4 clearance / 2.8 pilot), moved clear of the arms, recess end gaps closed; dovetail experiment dropped
    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
    [base.stl, dovetail-base.stl, dovetail-keeper.stl, dovetail-u-yoke.stl, u-yoke.stl]
2026-11-12 Base: UNLOCK text removed, arrows raised 0.6 mm instead of engraved
    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
    [base.stl]
2026-11-12 V45 sled: clip-in hall sensor pocket (lips + crush rib, no glue)
    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
    [v45-sled.stl]
2026-11-12 V45 sled: hall pocket lips are now 45-degree dovetails
    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
    [v45-sled.stl]
2026-11-12 V45 sled: hall pocket matches the SS49E's own chamfered profile, face flush, no rib
    Measured sensor 4.0 wide, 1.58 thick, face 2.65, 0.77 straight sides; pocket 0.075 oversize.
    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
    [v45-sled.stl]
2026-11-12 Beginner wiring guide with a picture that uses the board's printed pin names
    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
2026-11-12 Easy wiring picture: ESP32 drawn like the real ELEGOO board (chip, antenna, EN/BOOT, USB-C)
    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
2026-11-12 App, alerts and guides: say 'away from the motor' / 'where the avocado goes' instead of 'nest'
    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
2026-11-12 Wiring guide: hold the push-on wires, and the stuck-homing symptom of a loose power wire
    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
2026-11-12 Home button always runs the full travel back (no end-stop switch, so lost steps could leave it mid-way)
    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
    [machine.h]
2026-11-12 Assembly: glue the lead screw onto the motor shaft (homing pulls a dry fit off)
    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
2026-11-12 Home is set once by hand and counted, never found by running into the stop
    Stalling the 28BYJ-48 against the end stop pulled the lead screw off the motor
    shaft instead of slipping. Now: 'Set home here' (setup checklist step and Motor
    panel) with the sled touching the stop; the step count is saved to NVS after
    every move, with a 'moving' flag so a power cut mid-move asks for home again.
    Home and retract drive back to 0 by count. Jogs stop at home (5 mm) and at
    max_travel; 1 mm jogs may creep past home to correct it. Flipping motor_invert
    mirrors the count. Measure/blade/home refuse until home is set. No glue needed.
    Claude-Session: http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
    [config.h, machine.h, mock_device.py, stepper.h, web.h]
2026-11-12 Wiring guide: picture of the hall sensor's legs, in the hand and in the sled
    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
2026-11-12 Live sensor test panel (and /api/raw): watch the hall reading move while you push the blade
    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
2026-11-12 Firmware updates over Wi-Fi from the device page (Check for updates / Update now)
    CI writes the commit into build_id.h and the Pages manifest; the device
    compares, then HTTPUpdate pulls ripeomatic.app.bin into the spare OTA slot
    and restarts. NVS and LittleFS are untouched.
    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
2026-11-12 Settings: Save sends only the fields you changed (the stale form overwrote a fresh calibration)
    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
2026-11-12 Fixed V-holder replaces the hanging bowl (any 55-80 mm avocado wedges in, no rolling, no flex)
    One rigid part: floor tilted 12 degrees back, wall square to it, end walls,
    ribs under the floor that stay clear of the sled and rails; the foot drops into
    the old yoke recess and takes the same four M3 screws. Printed on the back of
    its wall, no supports. tools/v_holder.py builds it and checks the fit against
    the base, the V45 sled/blade/pad at max travel 37, and the reach for 55-80 mm
    fruit. Print guide, assembly, parts list and plates updated.
    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
    [v-holder.stl]
2026-11-12 Avocado holder with a servo back gate, clicking onto keyhole studs on the base
    The V-holder's back wall is a door hinged 5 mm under the floor and 5 mm
    behind the wall, so opened 88 degrees it lines up with the floor and the fruit
    rolls out the back. A servo drives it through a lever and link whose
    straight-line (toggle) position locks it shut against the pad's push. The
    frame clicks onto 4 v3 studs (old yoke slot and holes filled); the pad pushes
    in the locking direction. tools/back_gate.py builds the frame, door, lever,
    link and base and checks fits and every motion for collisions.
    Firmware: servo compiled in by default; 'Back gate fitted' and 'Drop ripe
    avocados into the basket' settings;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
    [base-v1-yoke-slot.stl, base.stl, gate-door.stl, gate-frame.stl, gate-lever.stl, gate-link.stl]
2026-11-12 Back gate redesigned: servo under the floor, 70 mm fruit centred on the pad, 5 mm sled tunnel
    The first gate centred an 80 mm avocado, so a 55 mm one was hit 14 mm high
    (31 degrees), left the sled 1.5 mm under the floor, and hung the servo in a
    housing behind the base. Now the corner is 5.4 mm higher and 3 mm nearer the
    pad (50-80 mm fruit reached, 6 mm below to 12 mm above the middle), the sled
    runs into a tunnel, and the servo sits in a pocket under the floor on the
    board side with lever, curved link and horn flat on the outside of the wall.
    Shut is an over-centre lock: horn and link in line, parked a few degrees past
    against a bump on the link. Keyholes staggered so they no longer overlap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
    [base.stl, gate-door.stl, gate-frame.stl, gate-lever.stl, gate-link.stl]
2026-11-12 Base: close the two windows under the new holder
    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
    [base.stl]
2026-11-12 All current parts in one print-oriented 3MF
    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
    [ripeomatic-all-parts.3mf]
2026-11-12 Base: fills planed exactly flush with the deck (no hairline seams in the slicer)
    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
    [base.stl, ripeomatic-all-parts.3mf]
2026-11-12 Holder: sled tunnel 6 mm deeper and shorter floor front, so the full 42 mm travel is usable (45-80 mm fruit)
    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
    [gate-frame.stl, ripeomatic-all-parts.3mf]
2026-11-12 Docs: sled runs 12 mm under the floor at full travel
    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
2026-11-12 Optional drop-in liner for small avocados (hooks over the floor's front edge)
    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
    [gate-liner-small.stl]
2026-11-12 All-parts 3MF includes the liner
    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
    [ripeomatic-all-parts.3mf]
2026-11-13 Base: screw-hole plugs trimmed flush with the underside (they stuck out 0.15 mm and were all that touched the bed)
    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
    [base.stl, ripeomatic-all-parts.3mf]
2026-11-14 Holder: cable relief at the closed end of the servo pocket; base: raised arrow for the holder's unlock direction
    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
    [base.stl, gate-frame.stl, ripeomatic-all-parts.3mf]
2026-11-14 Holder studs moved outside the sled's width (two were in the way of sliding the sled in); assembly check added
    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
    [base.stl, gate-frame.stl, ripeomatic-all-parts.3mf]
2026-11-14 Linkage assembly diagram (four screws, stack order) drawn from the model
    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
2026-11-14 Wiring picture and guide: back-gate servo added
    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
2026-11-14 Jog: a 5 mm step toward the motor can go past home after a confirm (for when the count is wrong)
    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
    [machine.h, mock_device.py, web.h]
